Kinglerrr/LoraWAN-Fire-Detector/HARDWARE/v1.0.0/smokse_detector.png

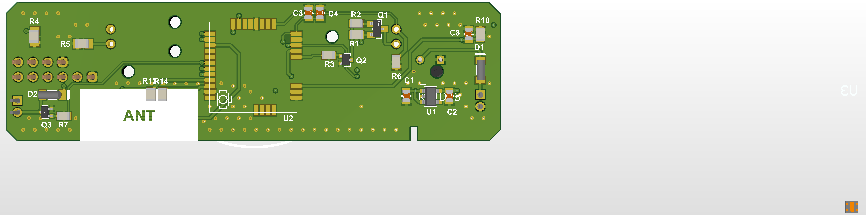
HARDWARE/v1.0.0/smokse_detector.png
