Kinglerrr/LoraWAN-Fire-Detector/(list of files, drawings)

Other design files:
HARDWARE/v1.0.0/smoke_detector.PcbDoc
HARDWARE/v1.0.0/smoke_detector.PrjPcb
HARDWARE/v1.0.0/smoke_detector.SchDoc
